llublad/MUSI-AREES/(commit log)

2021-05-16 migrate location MUSIEmonLib to ~/Arduino/libraries
2021-05-19 Taula d'errors incorporada al README.md
    [SensorCurrent.ino]
2021-05-19 Nova calibració al sensor SCT013-000
